petermuenstermann/Blupp/network.h

#include <ESP8266WiFi.h>
#include <ESP8266WiFiMulti.h>
//#include <WiFiUdp.h>

#include <ESP8266mDNS.h>
#include <ESP8266WebServer.h>

#include <FS.h>

void networkInit(void);
void HTTPHandleRequest(void);
